zhangxin0518/-/光学载荷CPCI-3U板卡2.png

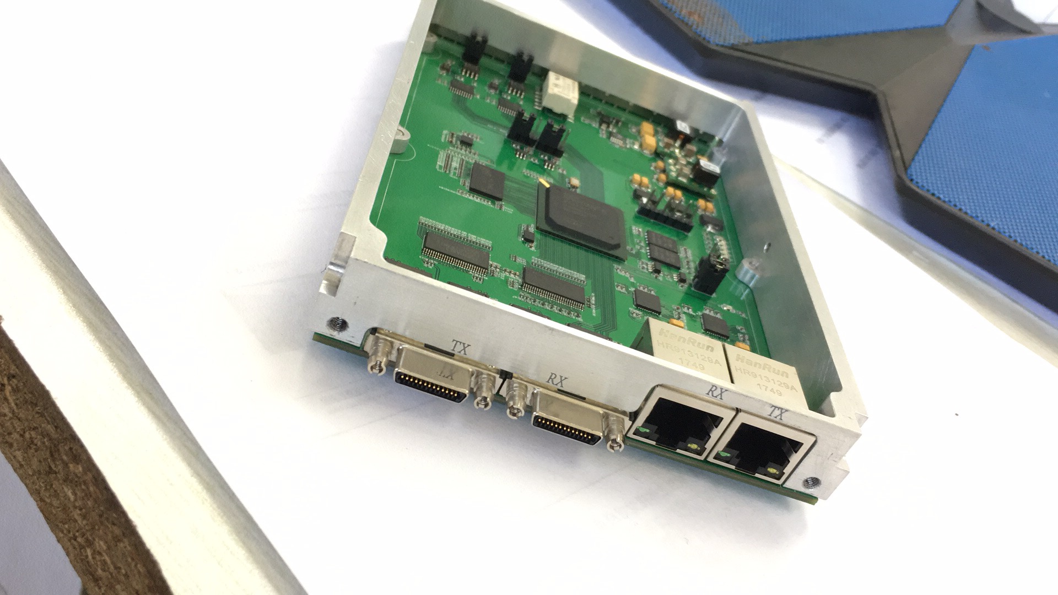
光学载荷CPCI-3U板卡2.png
