zhangxin0518/-/README.md

# Optical-Load
  FPGA-XC6SLX150
  
# 小型维纳卫星光学载荷板卡项目
# 如有转载下载，请联系本人：zhangxin0518@outlook.com
