zhangxin0518/-/系统总体图.jpg

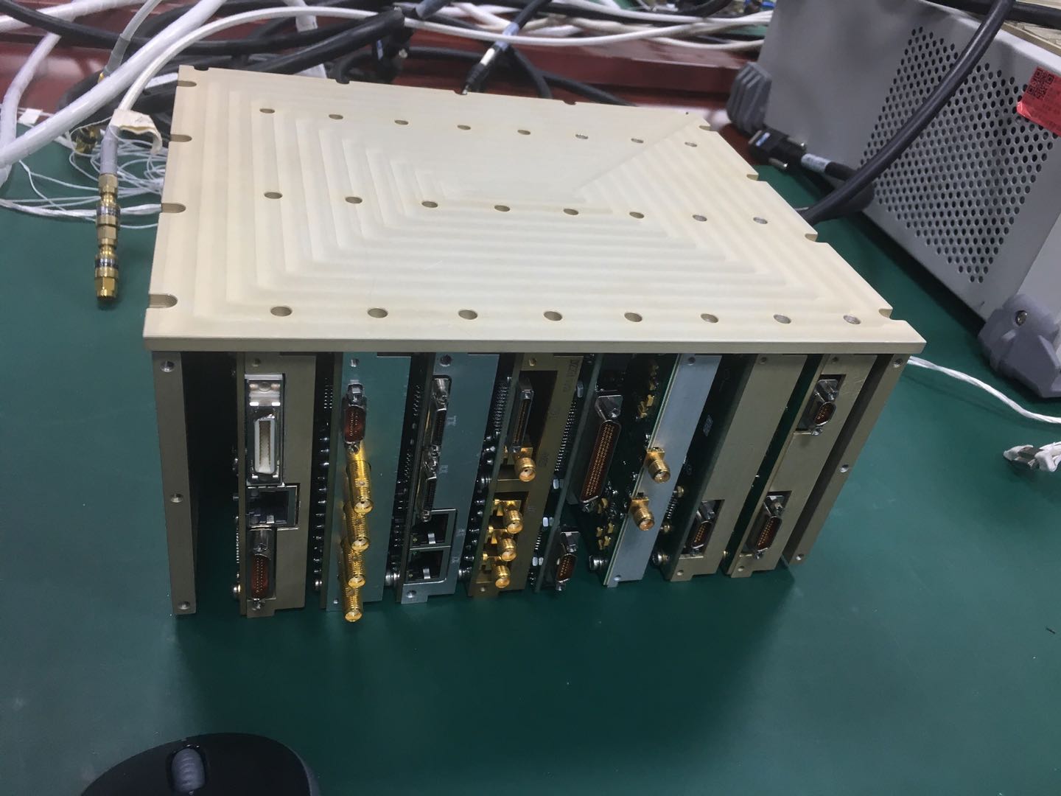
系统总体图.jpg
