zhangxin0518/-/小型维纳卫星光学载荷板卡项目/Hardware/XC6SLX150的BOM清单.xlsx

Comment | Description | Designator | Footprint | LibRef | Quantity
22pF | Capacitor | C1, C5, C12, C15 | 0402_C | Cap | 4
4.7uF | Capacitor | C2, C8, C11, C13, C65, C66 | 0402_C | Cap | 6
104 | Capacitor | C3, C4, C7, C10, C14, C16, C17, C18, C19, C20, C21, C23, C24, C28, C29, C30, C31, C32, C33, C35, C36, C41, C43, C44, C45, C47, C49, C52, C54, C55, C58, C63, C406 | 0402_C | Cap | 33
470pF | Capacitor | C6, C9 | 0402_C | Cap | 2
106 | Capacitor | C22, C34, C99, C100, C102, C103, C105, C106 | CASE_A | CAP POL1 | 8
102 | Capacitor | C42, C48, C50, C64 | 0402_C | CAP | 4
103 |  | C46, C51, C53, C56, C114 | 0402_C | CAP | 5
104 | Capacitor | C59, C70, C71, C72, C73, C74, C75, C76, C77, C78, C81, C82, C83, C84, C85, C86, C87, C88, C89, C90, C91, C92, C93 | 0201_C | Cap | 23
106 | Capacitor | C60, C61, C62, C67, C68 | 0402_C | Cap | 5
106 | Capacitor | C69 | 0201_C | Cap | 1
103 |  | C94, C95, C98, C101, C104 | 0603 | CAP | 5
107 | Capacitor | C96, C97 | CASE_A | CAP POL2 | 2
22uF | Capacitor | C107 | CASE_C | CAP POL1 | 1
104 |  | C108, C109 | 0603 | CAP | 2
103 |  | C110, C111 | 0805 | CAP | 2
107 | Capacitor | C112, C113 | CASE_C | CAP POL2 | 2
475 | Capacitor | C127, C128, C129, C130, C131, C132, C133, C134, C135, C137, C138, C139, C140, C141, C142, C143, C144, C145, C146, C147, C150, C151, C152, C153, C154, C155, C156, C157, C158, C173, C174, C175, C176, C177, C178, C179, C180, C181, C182, C183, C184 | 0201_C | Cap | 41
107 | Capacitor | C136 | 0201_C | Cap | 1
LED |  | D1, D2, D3, D4, D7, D8 | 0603_LED_S1 | LED | 6
SD0805 | SD0805 | D5, D6 | 0805_DIODE | 1N4148 | 2
2A/24V | PTC,RUEF110,Ih=1.1A_It=2.2A | F1 | 0805 | RUEF110 | 1
CPCI_A1 |  | J1 | H2A110FMDC | CPCI_A1 | 1
CPCI_B1 |  | J2 | H2B110FMDC | CPCI_B1 | 1
Header 6 | Header, 6-Pin | JTAG1 | HDR1X6 | Header 6 | 1
TQ2SL-L2-5V |  | K1 | TQ2SL-L2-5V | TQ2-L2-5V | 1
Header 2 | Header, 2-Pin | P1, P4, P5, P6 | HDR1X2 | Header 2 | 4
Header 3 | Header, 3-Pin | P2, P3, P7 | HDR1X3 | Header 3 | 3
AO3400A | N-channel Enhancement Mode Field-Effect Transistor; 5.8A/30V | Q1 | LC-SOT-23(SOT-23-3) | AO3400A | 1
33R | Resistor | R1, R62, R71, R73, R74, R76, R82, R83, R84, R86, R183 | 0402_R | RES1, Res2 | 11
10K | Resistor | R2, R14, R25, R46, R67, R78, R81, R91, R99, R108, R169, R224, R226 | 0402_R | RES1, Res2 | 13
0R | Resistor | R3, R5, R6, R8, R15, R17, R18, R20, R24, R209 | 0402_R | RES1, Res2 | 10
120R | Resistor | R4, R16, R28, R29, R44, R45 | 0402_R | RES1, Res2 | 6
22R | Resistor | R7, R11 | 0402_R | Res2 | 2
4K7 | Resistor | R9, R10, R12, R13, R79 | 0402_R | RES1, Res2 | 5
220R |  | R19, R21, R22, R23, R227 | 0402_R | RES1 | 5
49.9R |  | R26, R27, R30, R32, R47, R48, R49, R51 | 0402_R | RES1 | 8
50R |  | R31, R33, R38, R39, R50, R52, R58, R60 | 0402_R | RES1 | 8
1K5 |  | R35, R54 | 0402_R | RES1 | 2
4.87K 1% |  | R36, R55 | 0402_R | RES1 | 2
2K2 |  | R37, R56 | 0402_R | RES1 | 2
1K |  | R40, R80, R93, R111, R172, R800, R801, R802 | 0402_R | RES1 | 8
100R |  | R63, R68, R70, R75, R89, R106, R115, R124, R132, R140, R159 | 0402_R | RES1 | 11
100K |  | R64, R207 | 0402_R | RES1 | 2
2.4K |  | R66, R85 | 0402_R | RES1 | 2
25R |  | R100, R102, R104, R105, R107, R109, R110, R112, R114, R116, R117, R118, R119, R120, R122, R123, R125, R126, R127, R128, R130, R131, R133, R134, R135, R136, R138, R139, R141, R142, R143, R144, R146, R147, R148, R149, R151, R152, R155, R156, R157, R158, R160, R161, R163, R164, R165, R166, R167, R168, R170, R171, R173, R174, R175, R176, R177, R178 | 0201_R | RES1 | 58
10K |  | R113 | 0201_R | RES1 | 1
0R |  | R179, R180, R181, R182 | 0201_R | RES1 | 4
50R |  | R184, R185, R186, R187, R188, R189, R190, R191, R192, R193, R194, R195, R196, R197, R198, R199, R201, R202, R203 | 0201_R | RES1 | 19
100R |  | R200, R206 | 0201_R | RES1 | 2
4.7K |  | R204, R205 | 0201_R | RES1 | 2
100R 1% |  | R208, R211 | 0402_R | RES1 | 2
10K 1% |  | R210, R212 | 0402_R | RES1 | 2
27.4K 1% 100ppm |  | R213 | 0603 | RES1 | 1
500R |  | R214 | 0402_R | RES1 | 1
0.05R |  | R215 | 0805 | RES1 | 1
1K |  | R216 | 0805 | RES1 | 1
10R |  | R217 | 0603 | RES1 | 1
57K6 |  | R218 | 0603 | RES1 | 1
110K |  | R219 | 0603 | RES1 | 1
4K99 |  | R220 | 0603 | RES1 | 1
20K |  | R221 | 0603 | RES1 | 1
10K |  | R222 | 0603 | RES1 | 1
348R 1% 100ppm |  | R223 | 0603 | RES1 | 1
330R |  | R225 | 0402_R | RES1 | 1
HR913129A | HanRun 1 Port Tab Upright RJ45 Connector With Integrated Magnetics and LED for 10/100 Base TX NIC Applications | RJ1 | HR913129A | HR913129A | 1
CameraLink_BOARD | CameraLink_F | SDR1 | mini_SDR26 | CameraLink_F | 1
CameraLink_CAMERA |  | SDR2 | mini_SDR26 | Camera Link | 1
SMAJ18CA | Transient Voltage Suppressor,24V Stand-off Voltage, Bi-Directional, -55 to 155 degC, 2-pin DO-214AC, Pb-Free, Tape and Reel | T1 | SMAJ18CA | SMAJ24CA | 1
50MHz |  | U1 | OSC3225 | CLK | 1
MCP2515-I/ST | Stand-Alone CAN Controller With SPI Interface, 20-Pin TSSOP, Industrial Temperature | U2, U7 | TSSOP-ST20_N | MCP2515-I/ST | 2
XC6SLX150-3FGG484I | Spartan-6 LX 1.2V FPGA, 338 User I/Os, 484-Ball Fine-Pitch BGA (1.0mm Pitch), Speed Grade 3, Industrial Grade, Pb-Free | U3 | FGG484 | XC6SLX150-3FGG484I | 1
SN65HVD230DR | 3.3V CAN Transceiver with Standby Mode, 17 mA, -40 to 85 degC, 8-pin SOIC (D), Green (RoHS & no Sb/Br) | U4, U8 | D8_L | SN65HVD230DR | 2
ADC081C021CIMKX/NOPB | I2C-Compatible, 8-Bit Analog-to-Digital Converter with Alert Pin, 6-pin Tiny SOT23, Pb-Free | U5, U6 | MK06A_N | ADC081C021CIMKX/NOPB | 2
DP83848KSQ | PHYTER?Mini LS Industrial Temperature Single Port 10/100 Mb/s Ethernet Transceiver, 40-pin LLP | U9, U11 | SQA40B | DP83848KSQ | 2
TS3L301 |  | U10 | TSSOP-48 | TS3L301 | 1
DS90LV048ATM | 3V LVDS Quad CMOS Differential Line Receiver, 16-pin Narrow SOIC | U14 | M16A_N | DS90LV048ATM | 1
M25P64-VME6G |  | U15, U17 | MLP8 | M25P64 | 2
SN74LVC1G3157DBVR | Single-Pole, Double-Throw Analog Switch, DBV0006A, LARGE T&R | U16 | DBV0006A_N | SN74LVC1G3157DBVR | 1
DS90LV019TM | 3.3V or 5V LVDS Driver/Receiver, 14-pin Narrow SOIC | U18, U22 | M14A_N | DS90LV019TM | 2
DS90LV047ATM | 3V LVDS Quad CMOS Differential Line Driver, 16-pin Narrow SOIC | U19 | M16A_N | DS90LV047ATM | 1
DS90CR288AMTD | +3.3V Rising Edge Data Strobe LVDS 28-Bit Channel Link Receiver - 85 MHz, 56-pin TSSOP | U20 | MTD56_N | DS90CR288AMTD | 1
DS90CR287MTD | +3.3V Rising Edge Data Strobe LVDS 28-Bit Channel Link Transmitter - 85 MHz, 56-pin TSSOP | U21 | MTD56_N | DS90CR287MTD | 1
120MHz |  | U23 | OSC3225 | CLK | 1
MT47H64M16HR-3 AAT | 1Gb DDR2-667 SDRAM, 64Mb x 16, 3ns, 1.8V, -40 to 105 degC, 84-Ball FBGA, Pb-Free | U24 | MICT-HR-84 | MT47H64M16HR-3 AAT | 1
TPS51200DRCR | Single Output LDO, 3 A, 2.375 to 3.5 V Input, with DDR Termination, 10-pin SON (DRC), -40 to 85 degC, Green (RoHS & no Sb/Br) | U25 | TI-DRC10-2400X1650TP_V | TPS51200DRCR | 1
PTH08080WAS | 2.25 A, 4.5 to 18 V Input Wide Adjust Miniature Power Module, -40 to 85 degC, 5-pin Module (EUG5) | U26, U31 | TI-EUG5_V | PTH08080WAS | 2
LM1117MPX-3.3 | 800mA Low-Dropout Linear Regulator, 4-pin SOT-223 | U27, U28 | MP04A_N | LM1117MPX-3.3 | 2
LM1117MPX-1.8 | 800mA Low-Dropout Linear Regulator, 4-pin SOT-223 | U29 | MP04A_N | LM1117MPX-1.8 | 1
LT4363IMS-2#PBF | High Voltage Surge Stopper with Current Limit, 4 to 80 V Vin, 12-pin SOP (MS-12), -40 to 85 degC, Pb-Free | U30 | LT-MS-12_N | LT4363IMS-2#PBF | 1
SN74LVC1G373DBVR | Single D-Type Latch with 3S Output, DBV0006A, LARGE T&R | U106 | DBV0006A_N | SN74LVC1G373DBVR | 1
8MHz | Crystal Oscillator | Y1, Y2 | X1 | XTAL | 2
