zhangxin0518/-/小型维纳卫星光学载荷板卡项目/印制板（公开）.pdf

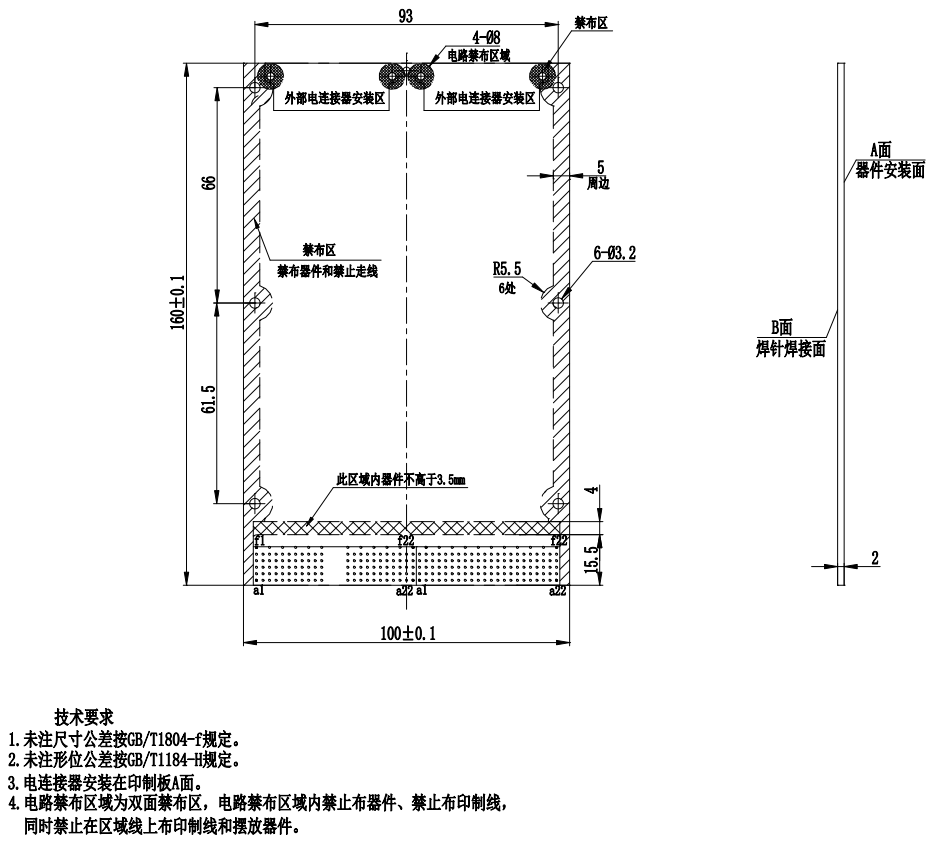
[picture p4: page 1]
