zhangxin0518/-/(list of files, cad)

Other CAD files:
小型维纳卫星光学载荷板卡项目/Project_document/印制板（公开）.dwg
